WildCrasher/LineFollower/Plytki/CNY70/CNY70.brd

## EAGLE design Plytki/CNY70/CNY70.brd (2017-06-10)

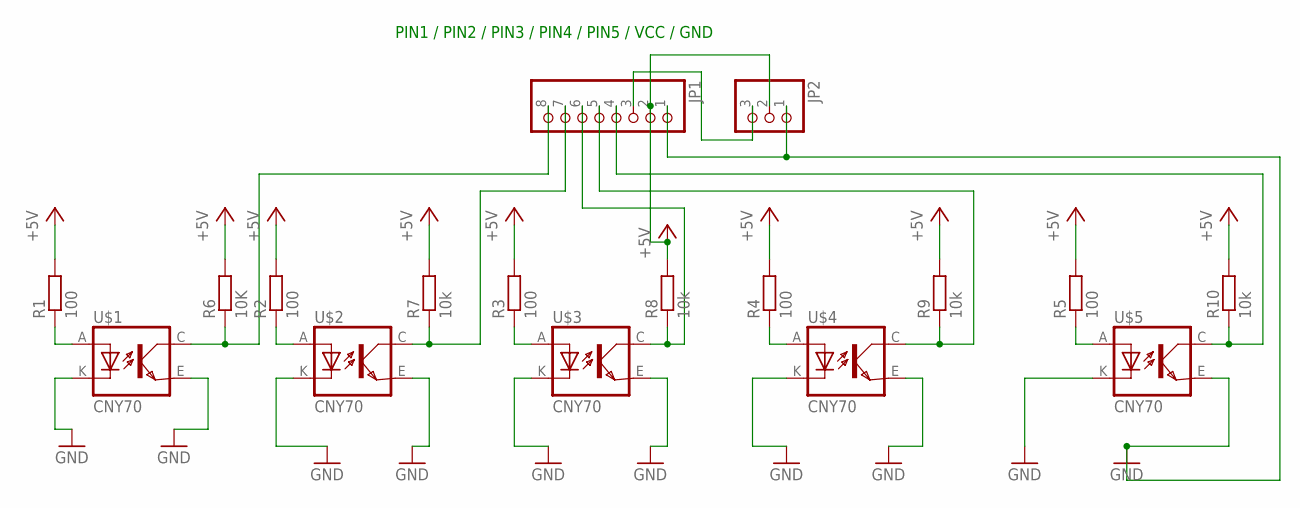
[picture p28: schematic CNY70.sch]

Parts:
JP1: PINHD-1X8; 1X08
JP2: PINHD-1X3; 1X03
R1, R2, R3, R4, R5: 100; 0309/12
R6: 10K; 0309/12
R7, R8, R9, R10: 10k; 0309/12
U$1, U$2, U$3, U$4, U$5: CNY70; 4

Connections:
+5V: JP1.2, JP2.2, R1.2, R2.2, R3.2, R4.2, R5.2, R6.2, R7.2, R8.2, R9.2, R10.2
GND: JP1.1, JP2.1, U$1.E (EMI), U$1.K (C), U$2.E (EMI), U$2.K (C), U$3.E (EMI), U$3.K (C), U$4.E (EMI), U$4.K (C), U$5.E (EMI), U$5.K (C)
unnamed: R1.1, U$1.A
unnamed: R2.1, U$2.A
unnamed: R3.1, U$3.A
unnamed: R4.1, U$4.A
unnamed: R5.1, U$5.A
unnamed: JP1.8, R6.1, U$1.C (COL)
unnamed: JP1.7, R7.1, U$2.C (COL)
unnamed: JP1.6, R8.1, U$3.C (COL)
unnamed: JP1.3, JP2.3
unnamed: JP1.4, R10.1, U$5.C (COL)
unnamed: JP1.5, R9.1, U$4.C (COL)

Notes on the sheet:
PIN1 / PIN2 / PIN3 / PIN4 / PIN5 / VCC / GND

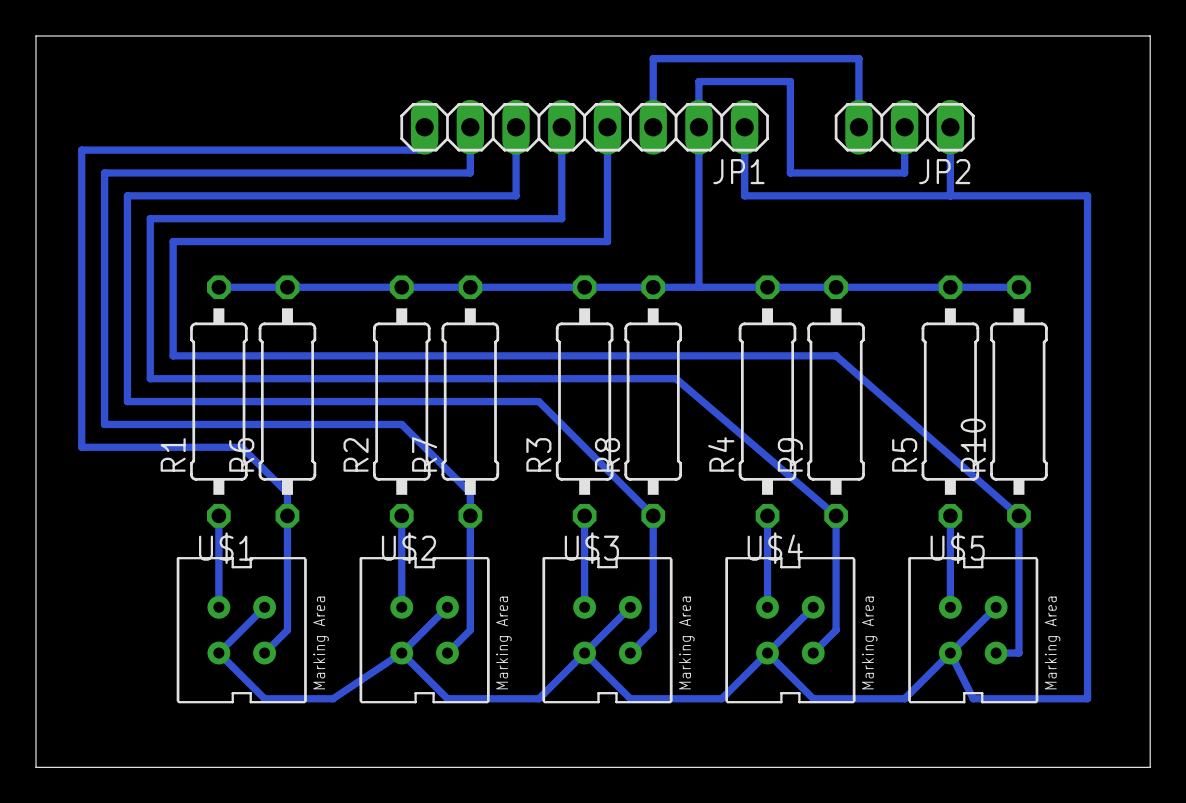
[picture p29: board CNY70.brd from above]

Board: 2 copper layers, 61.9 x 40.6 mm, 17 parts (0 on the bottom side), 13 nets.
