WildCrasher/LineFollower/Plytki/ATMEGA/line_follower.brd

## EAGLE design Plytki/ATMEGA/line_follower.brd (2017-06-10)

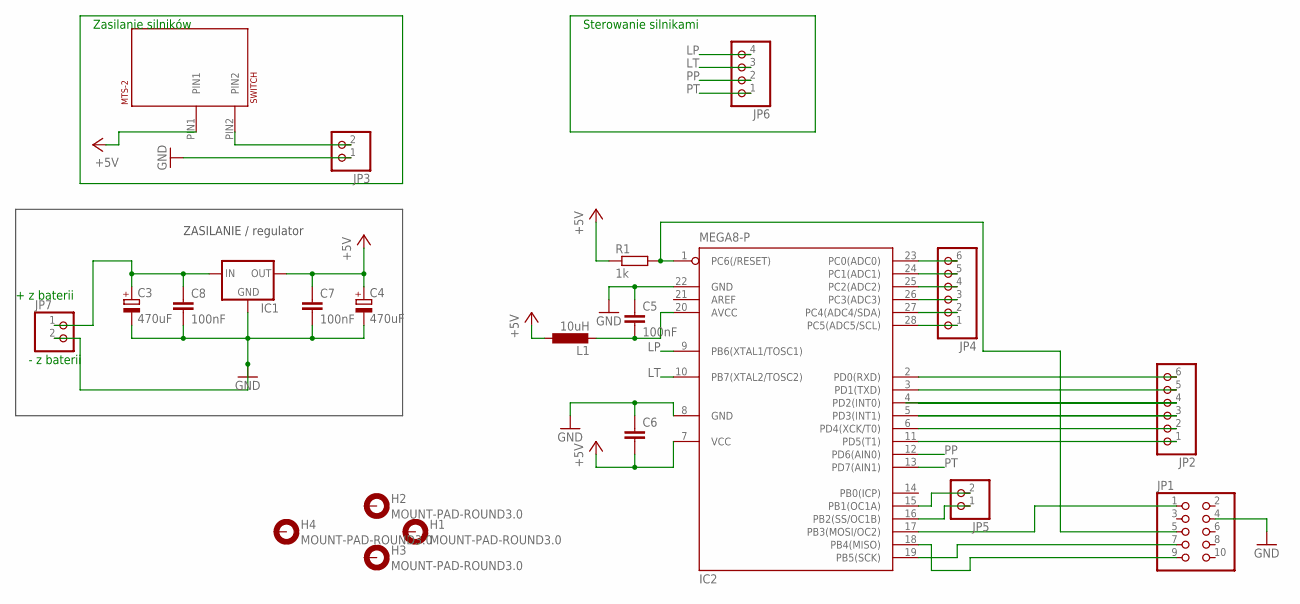
[picture p30: schematic line_follower.sch]

Parts:
C3, C4: 470uF; E2,5-6
C5, C7, C8: 100nF; C025-025X050
C6: C-EU025-025X050; C025-025X050
H1, H2, H3, H4: MOUNT-PAD-ROUND3.0; 3,0-PAD
IC1: 78XXS
IC2: MEGA8-P; DIL28-3
JP1: PINHD-2X5; 2X05
JP2, JP4: PINHD-1X6; 1X06
JP3, JP5, JP7: PINHD-1X2; 1X02
JP6: PINHD-1X4; 1X04
L1: 10uH; 0207/5V
MTS-2: SWITCH; MTS-2_SWITCH
R1: 1k; 0204/5

Connections:
+5V: C4.+, C6.2, C7.1, IC1.OUT, IC2.7 (VCC), L1.1, MTS-2.PIN1, R1.1
GND: C3.-, C4.-, C5.1, C6.1, C7.2, C8.2, IC1.GND, IC2.8 (GND), IC2.22 (GND), JP1.4, JP3.1, JP7.2
LP: IC2.9 (PB6(XTAL1/TOSC1)), JP6.4
LT: IC2.10 (PB7(XTAL2/TOSC2)), JP6.3
unnamed: C5.2, IC2.20 (AVCC), L1.2
unnamed: IC2.23 (PC0(ADC0)), JP4.6
unnamed: IC2.1 (PC6(/RESET)), JP1.5, R1.2
unnamed: IC2.17 (PB3(MOSI/OC2)), JP1.1
unnamed: IC2.18 (PB4(MISO)), JP1.9
unnamed: IC2.2 (PD0(RXD)), JP2.6
unnamed: IC2.19 (PB5(SCK)), JP1.7
unnamed: IC2.3 (PD1(TXD)), JP2.5
unnamed: IC2.4 (PD2(INT0)), JP2.4
unnamed: IC2.5 (PD3(INT1)), JP2.3
unnamed: IC2.6 (PD4(XCK/T0)), JP2.2
unnamed: IC2.11 (PD5(T1)), JP2.1
unnamed: C3.+, C8.1, IC1.IN, JP7.1
unnamed: IC2.24 (PC1(ADC1)), JP4.5
unnamed: IC2.25 (PC2(ADC2)), JP4.4
unnamed: IC2.26 (PC3(ADC3)), JP4.3
unnamed: IC2.27 (PC4(ADC4/SDA)), JP4.2
unnamed: IC2.28 (PC5(ADC5/SCL)), JP4.1
unnamed: IC2.15 (PB1(OC1A)), JP5.2
unnamed: IC2.16 (PB2(SS/OC1B)), JP5.1
unnamed: JP3.2, MTS-2.PIN2
PP: IC2.12 (PD6(AIN0)), JP6.2
PT: IC2.13 (PD7(AIN1)), JP6.1

Notes on the sheet:
ZASILANIE / regulator
Zasilanie silników
Sterowanie silnikami
+ z baterii
- z baterii

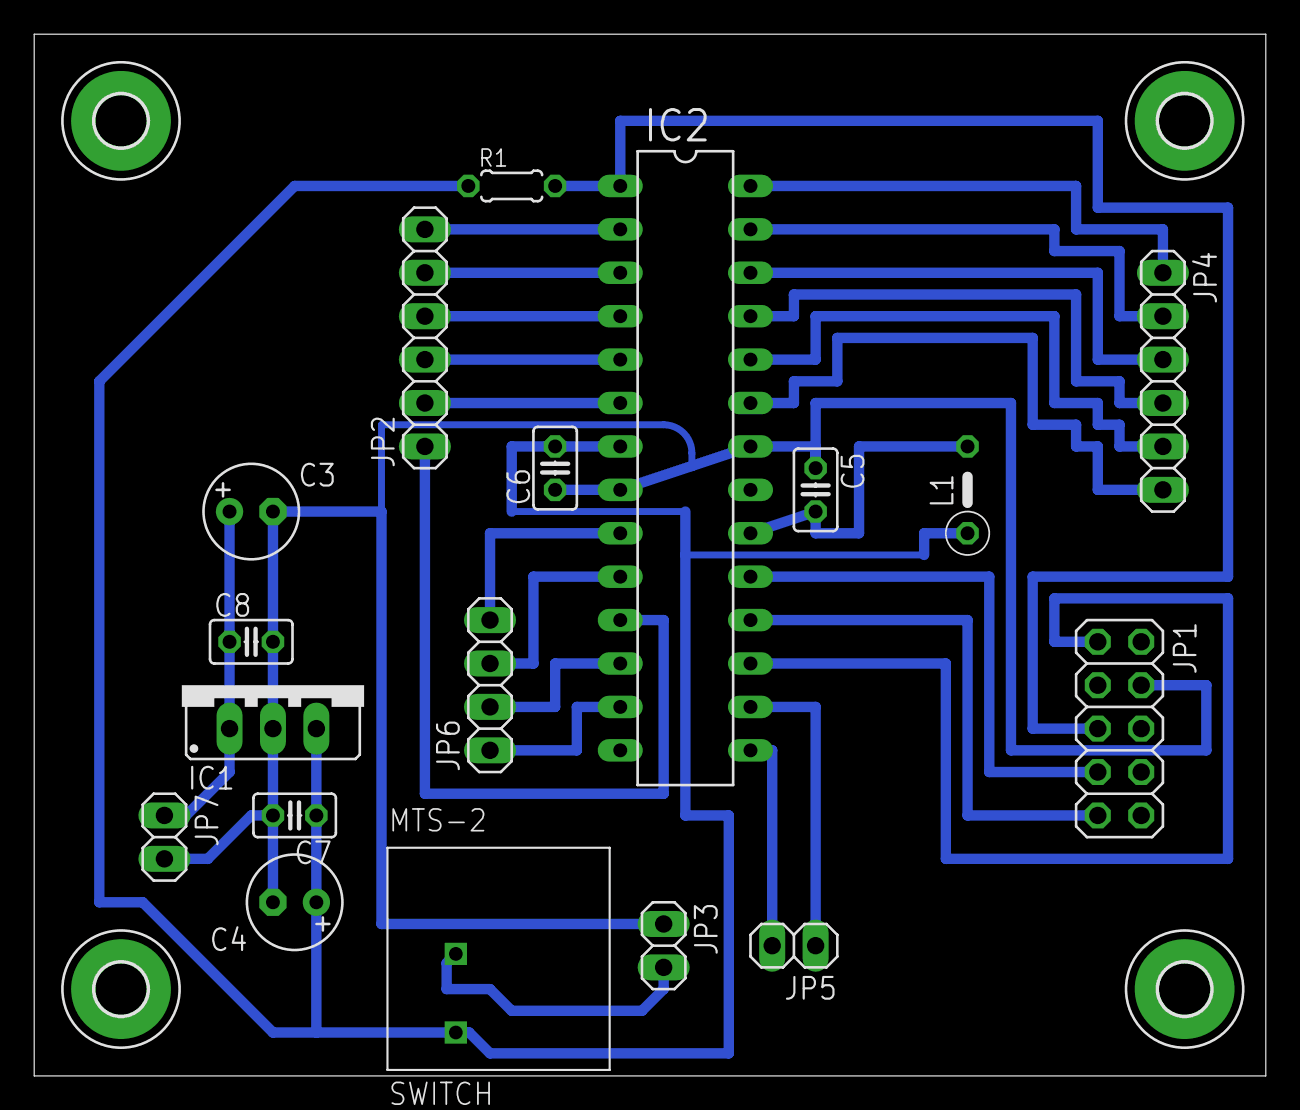
[picture p31: board line_follower.brd from above]

Board: 2 copper layers, 72.1 x 61.0 mm, 22 parts (0 on the bottom side), 27 nets.
