WildCrasher/LineFollower/Plytki/SHARP/czujnik_schemat.brd

## EAGLE design Plytki/SHARP/czujnik_schemat.brd (2017-06-10)

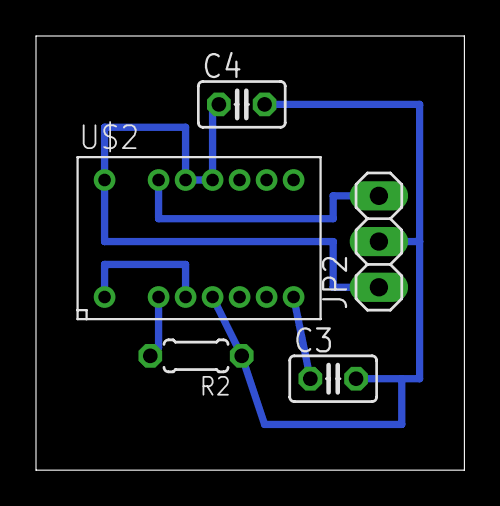
[picture p32: board czujnik_schemat.brd from above]

Board: 2 copper layers, 23.8 x 24.1 mm, 5 parts (0 on the bottom side), 6 nets.

Parts:
C3, C4: 0.1 μF; C025-025X050
JP2: 1X03
R2: 0204/5
U$2: LP16PIN

Connections:
GND: C3.2, C4.2, JP2.2, R2.1, U$2.4
unnamed: R2.2, U$2.2
unnamed: C3.1, U$2.7
unnamed: U$2.1, U$2.3
unnamed: JP2.3, U$2.13
VCC: C4.1, JP2.1, U$2.11, U$2.12, U$2.14
