WildCrasher/LineFollower/CodeArduino/main/config.ino

#define EN_11 20
#define EN_12 21
#define EN_21 6
#define EN_22 7
#define PWM1  9
#define PWM2  10
#define CZ_1 A5
#define CZ_2 A4
#define CZ_3 A3
#define CZ_4 A2
#define CZ_5 A1
//#define LED 0

//#define PWMP  OCR1B
//#define PWML  OCR1A
