WildCrasher/LineFollower/(commit log)

2017-06-10 DTR- dokumentacja, kod
    [CNY70.brd, CNY70.sch, line_follower.brd, line_follower.sch]
2017-06-10 Revert "DTR- dokumentacja, kod"
    This reverts commit e6b6094d8b0bc0e170c045d06224e803add3bae5.
    [CNY70.brd, CNY70.sch, line_follower.brd, line_follower.sch]
2017-06-10 Projekty plytek
    [czujnik_schemat.brd, czujnik_schemat.dxf, czujnik_schemat.sch]
2017-06-10 Ostateczne projekty plytek
    [CNY70.brd, CNY70.sch, czujnik_schemat.dxf, czujnik_schemat.sch, line_follower.brd, line_follower.sch]
